Xavier-GAO-42/thuairforce_uav_cuadc/README.md

# CUADC 2025 项目资料

我们需要制作一架固定翼无人机，可以自主起飞，在任务区域内识别数字或图像天井，然后决策向其中一个天井投放物资载荷(一瓶矿泉水)，并自主着落。在无人机起飞后的全流程中不允许对无人机进行任何操作行为。

## 从这里开始

| 想了解什么 | 阅读入口 |
|---|---|
| 飞机要完成什么任务，各设备如何协作 | [系统架构](2025/航电设计/01-系统架构.md) |
| 图像和位姿如何同步，为什么会有误差 | [图像与位姿对齐](2025/航电设计/02-图像与位姿对齐.md) |
| 系统如何部署、启动和排查问题 | [系统启动与操作流程](2025/使用说明/系统启动与操作流程.md) |
| 实现代码与配套文件 | [Jetson 主程序](2025/程序/jetson/README.md) · [树莓派采集系统](2025/程序/rpi5/README.md) |
| 飞机模型、制造文件和打印参数 | [模型与制造](2025/模型/README.md) |
| 最终参数候选及比赛航点 | [飞控参数与比赛航线](2025/飞控与航线/飞控参数与比赛航线.md) |
| 曝光条件和定位观测 | [曝光与定位记录](2025/曝光与定位/曝光与定位记录.md) |
| 当年遇到什么问题，后来考虑如何优化 | [2025 技术复盘](2025反思优化/2025反思与后续优化.md) |

建议先读系统架构的任务、设备分工和执行流程，再按需要进入同步专题、源码或复盘。正文中的未完成工作、推导过程和不同版本判断均保留；后续意见与当年记录分别标识。

署名与许可状态、版本差异和来源校验见 [整理记录](整理记录/README.md)。
