Xavier-GAO-42/thuairforce_uav_cuadc/2025/README.md

# 2025 成果资料

## 1. 理解设计

- [系统架构](航电设计/01-系统架构.md)：任务目标 → 系统总览 → 设备分工 → 执行流程 → 模块设计 → 工程问题。架构图和模型分析图直接放在对应正文中。
- [图像与位姿对齐](航电设计/02-图像与位姿对齐.md)：数据流 → 时间链路 → 匹配机制 → 误差推导 → 原文修正与后续判断。

## 2. 查看实现

- [Jetson 任务程序](程序/jetson/README.md)
- [树莓派图像采集系统](程序/rpi5/README.md)
- [模型与制造](模型/README.md)：整机 CAD、一个可编辑打印工程、打印参数说明及少量独立制造文件。
- [曝光与定位记录](曝光与定位/曝光与定位记录.md)：曝光条件、原始观察和聚类配图。

代码目录及运行所需的配置、航点、模型、测试图片、日志和笔记保持原相对路径。

## 3. 部署与复现

- [系统启动与操作流程](使用说明/系统启动与操作流程.md)
- [飞控参数与比赛航线](飞控与航线/飞控参数与比赛航线.md)：一份最终参数候选及第二轮比赛的六份任务文件。
- [SITL、航点与 DroneKit 开发笔记](程序/jetson/note/note_navigate.md)
- [开发与配置记录](程序/jetson/note/README.md)

## 4. 复盘与版本

- [2025 技术复盘与后续优化](../2025反思优化/2025反思与后续优化.md)
- [历史程序版本差异](../整理记录/历史程序版本差异/README.md)
- [资料来源与整理记录](../整理记录/README.md)
