Xavier-GAO-42/thuairforce_uav_cuadc/2025/模型/README.md

# 2025 模型与制造

## 1. 整机模型

- [整机 STEP](飞机最新版.STEP)：通用交换格式，便于查看和导入 CAD 软件。
- [整机 SolidWorks 零件](飞机最新版.（整体）SLDPRT.SLDPRT)：原生零件格式归档。

这两份为原有整机文件，文件名保持原样。本次未用 CAD 软件打开核验，尚未确认内部细节及比赛最终版身份；整体零件文件不等同于保留全部装配约束和建模历史的装配工程。

## 2. 打印工程与参数

- [v3.99 可编辑整机打印工程](打印工程/v3.99整机-可编辑.3mf)：只保留这一份 3MF，包含整机零件及原打印设置。
- [打印参数与说明](打印参数与说明.md)：材料、温度、层高、填充、支撑和取件说明，并列出不同零件设置的差异及待确认项。

## 3. 独立制造文件

保留少量适合单独加工、修改的文件，其余零件通过整机模型查看。

| 用途 | 文件 |
|---|---|
| 航电甲板，原文件标注板厚 1.7 mm | [底板](制造文件/电设甲板-底板1.7mm.DXF) · [侧板](制造文件/电设甲板-侧板1.7mm.DXF) · [前后板](制造文件/电设甲板-前后板1.7mm.DXF) |
| 起落架 | [加工图 DXF](制造文件/起落架.DXF) |
| 短夹具 | [实心短夹具 SolidWorks 零件](制造文件/实心短夹具.SLDPRT) |

这些文件保留源文件内容。本次未进行 CAD 装配检查、尺寸验收或实际打印验证；未附完整生产图和材料清单。
