Xavier-GAO-42/thuairforce_uav_cuadc/2025/结构设计/README.md

# 2025 结构设计文件

## 目录

- [1. 文件说明](#nav-1)

## 1. 文件说明

- `飞机最新版.STEP`：通用交换格式整机文件。
- `飞机最新版.（整体）SLDPRT.SLDPRT`：SolidWorks 原生零件格式归档。

两个文件均来自历史迁入归档，文件名保持原样。本次未用 CAD 软件打开核验，尚不能确认外部引用、内部细节或比赛最终版身份。它们不等同于完整装配工程、生产图或材料清单。
