Xavier-GAO-42/thuairforce_uav_cuadc/整理记录/历史程序版本差异/README.md

# 历史程序版本差异

## 1. 不同版本

- `cuadc/navigate.py`：独立历史仓库中的另一完整版本。
- `cuadc/.gitignore`：独立历史仓库中的忽略配置。

## 2. 与主程序的关系

这些文件与主归档不同，作为版本对照保留，不是完整可运行副本，也没有覆盖[主程序](../../2025/程序/jetson/README.md)。
