Xavier-GAO-42/thuairforce_uav_cuadc/2025/程序/jetson/README.md

# 2025 Jetson 任务程序

## 1. 先了解系统

[系统架构](../../航电设计/01-系统架构.md)介绍任务流程、硬件连接、服务环境、模块分工、模型与已知问题。

图像与位姿匹配的完整说明和误差推导见 [图像与位姿对齐](../../航电设计/02-图像与位姿对齐.md)。

## 2. 查看程序

主入口为 main.py；config、waypoint、model、picture_test、log 与 note 保持原目录结构。具体文件与模块说明见[系统架构的 Jetson 程序设计](../../航电设计/01-系统架构.md#architecture-4)。

## 3. 部署与调试

- [系统启动与操作流程](../../使用说明/系统启动与操作流程.md)
- [SITL、航点与 DroneKit 笔记](note/note_navigate.md)
- [开发与配置记录](note/README.md)
- [2025 技术复盘](../../../2025反思优化/2025反思与后续优化.md)

源码逻辑未因文档整理而修改。
