Xavier-GAO-42/thuairforce_uav_cuadc/整理记录/发布说明.md

# 发布准备说明

## 1. 材料范围与状态

本包为 2025 成果、原始技术说明及后续复盘。原文中的后续迁移意见、推导、不确定判断、未完成工作和不同版本表述均保留，不把它们写成已完成成果。

署名、许可证、模型与数据来源、图片和 CAD 的权属审阅仍待确认；缺少完整数据集、部分原文提及的权重、部署镜像、完整生产图和材料清单，未确认所有文件的比赛最终版身份。

本次从桌面归档补充一份最终飞控参数候选、第二轮比赛六份航点、曝光与定位技术记录，以及一个可编辑整机 3MF、打印说明和五份独立制造文件。未纳入比赛过程总结、事故分析、飞行调参历史、曝光照片全集或旧参数快照。参数适用机体、航点 Home 不一致、打印局部填充差异等未确认项在对应正文中标明。

## 2. 组织原则

阅读入口围绕“理解任务 → 理解系统 → 查看专题分析 → 查看实现与操作 → 复盘”组织，不按来源文件名建立知识分类。航电设计只保留系统架构、图像与位姿对齐两篇正文和供正文引用的配图。

架构文档中的任务、流程、设备分工、模块、模型、问题和未完成工作重新排序，原句保留。对齐专题中两版独有的触发说明、误差表与判断就地并列，保留结论变化的过程。

程序运行所需的文件名、目录、相对路径与逻辑不变。图片按用途命名，嵌入相应内容。原始测试图片继续在程序目录中保留，不再复制为航电主题。来源、校验和不同程序版本集中到本目录。

## 3. 内容保留边界

技术分析、参数表、公式、代码片段、实验过程和原始异议不通过摘要替代。只合并重复内容，独有内容保留。原始文件仍在工作区原仓库，本次修改前另存了完整备份。

原启动文档两处设备登录口令及其占位提示均不公开。个人用户名路径、内部镜像索取、个人仓库链接和无关写作感叹已清理；复盘中的个人姓名匿名化，技术异议保留。其余技术步骤、推导和判断保留，程序中的历史坐标、内网地址和设备路径未改写。

文本凭据、邮箱、手机号及附件常见凭据模式的检查结果见 `敏感信息检查.json`。二进制模式检查不等于模型或 CAD 的全部内部元数据已人工审阅。

## 4. 验证范围

核对原始材料是否存在对应位置、非文档附件是否与原文件哈希一致、技术正文是否完整覆盖、图片引用与文档链接是否有效。记录与清单见本目录。

没有执行主程序、硬件试验、模型推理或 CAD 内容验收。文档整理及文件校验不代表飞行、复现或发布授权验收完成。
