Xavier-GAO-42/thuairforce_uav_cuadc/2025/模型/打印参数与说明.md

# v3.99 模型打印参数与说明

[可编辑整机 3MF](打印工程/v3.99整机-可编辑.3mf)包含分件摆盘和打印配置。来源为 `v3.99两盘一架（右喷头）.3mf`，内部日期为 2025-09-22，创建软件标记为 BambuStudio 02.02.00.85。本目录只保留这一份打印工程。

## 1. 工程中的全局设置

以下参数直接读取 `Metadata/project_settings.config`，不是重新给出的通用打印配方。

| 项目 | 原工程设置 |
|---|---|
| 打印机 | Bambu Lab H2D，右喷头项目 |
| 喷嘴 | 0.4 mm |
| 耗材 | Bambu ASA-CF |
| 层高 / 首层层高 | 0.24 / 0.2 mm |
| 墙层数 | 1 |
| 全局填充 | 2%，自适应立方体（adaptivecubic） |
| 顶 / 底壳层数 | 3 / 3 |
| 象脚补偿 | 0.1 mm |
| XY 外轮廓 / 孔补偿 | 0 / 0 mm |
| 支撑 | 开启，自动树状支撑 |
| 喷嘴温度 | 首层及其他层均为 275°C |
| 当前底板 | Textured PEI Plate |
| 对应该底板的床温设置 | 90°C |
| 仓温设置 | 60°C |

文件还存有其他底板 100°C 的预设值，不与当前纹理板 90°C 混写。更换设备、耗材或底板后不能直接把上表视为已经验证的适配参数。

## 2. 对象覆盖与局部设置

工程并非所有零件都使用全局 2%：

| 对象 ID | 原对象名称 | 填充设置 |
|---|---|---|
| 30 | 最新版机身-SOLID-6 | 显式覆盖 3% |
| 28 | 最新版机身-SOLID-5 | 显式覆盖 3% |
| 47 | 最新版机身-SOLID-6 | 未覆盖，继承 2% |
| 26 | 最新版机身-SOLID-1 | 未覆盖，继承 2% |

部件树中还存在局部 100% 填充设置。以上覆盖、修改器、支撑和摆放均保留在可编辑工程中，不用一张全局参数表替代。

**待确认：** 同一整机工程的机身对象存在 2%/3% 差异，是有意设计还是遗漏没有明确记录。请在切片软件中按对象核对，不能直接归纳为“全部机身 3%”。

## 3. 冷却、拆支撑与试件

原制造说明记录：

1. 打印结束后让箱温自然冷却到室温，原记录约需 2 h，再取出模型，避免热应力导致破裂。
2. 大树状支撑可以轻轻去除；细小支撑原记录要求由装配人员处理。
3. 床面粘性差时，原记录建议涂胶。
4. 设备状态不确定时，原记录建议先用 1 层墙、2% 填充打印直径 2 cm、高 10 cm 的倾斜圆柱作测试。

原公差说明另写探杆孔径增加 5%–6%，这是对应部件的历史要求，不应无区别套用到所有孔。旧说明中的象脚补偿为 0.15 mm，本工程为 0.1 mm，保留这一差异，不擅自统一。

## 4. 文件与制造边界

整机 STEP、SolidWorks 整体零件和本 3MF 的来源分别保留；本次没有验证三者的几何完全相同，也没有进行新的切片、打印或结构强度试验。

已有说明中的 38 h、900 g 对应另一次具体工程，不作为本文件的统一耗时和用料指标。没有附预切片 G-code，避免把特定机器的执行文件当成通用模型。
