Xavier-GAO-42/thuairforce_uav_cuadc/2025/飞控与航线/飞控参数与比赛航线.md

# 2025 飞控参数与比赛航线

这里只提供一份最终参数候选和第二轮比赛航线，不附历史调参过程或测试航点全集。

## 1. 飞控参数

[1008 自动降落参数表](飞控参数/1008自动降落（最终参数）.param)来自原文件 `1008自动降落（最终参数）.param`，包含 958 个参数项，文件内容保持不变。

“最终参数”为原文件命名，表示当前找到的 10 月 8 日候选，不等于已独立确认是所有比赛机体实际使用的最终配置。该文件没有配套记录固件版本与对应机体；设备 ID、传感器偏置和校准值属于当时的设备状态，不能当作通用设置。

## 2. 第二轮比赛航点

来源为 `德清第二轮比赛航点正确版.zip`。按阅读用途重命名，原始任务内容没有改写。

| 方向 | 侦察航线 | 降落航线 |
|---|---|---|
| 东侧（原 A 组） | [3 轮](比赛航点/东侧方向-侦察3轮.waypoints)、[4 轮](比赛航点/东侧方向-侦察4轮.waypoints) | [降落](比赛航点/东侧方向-降落.waypoints) |
| 西侧（原 B 组） | [3 轮](比赛航点/西侧方向-侦察3轮.waypoints)、[4 轮](比赛航点/西侧方向-侦察4轮.waypoints) | [降落](比赛航点/西侧方向-降落.waypoints) |

3 轮与 4 轮是不同任务选项，不是同一个任务的新旧版本。第二轮包的两份降落任务与普通比赛目录中的版本不同，本目录只采用第二轮包。

航点保留德清原场地坐标。归档文件本身不能证明当时实际上传和执行了完全相同的任务；复用时还需核对方向、坐标、高度基准和任务适用性。

六份文件的序号 0（Home）均在约 `30.4186, 120.0333`，后续非零目标坐标在约 `30.504, 120.106`，位置不一致，疑似保留了其他场地的 Home，原因未确认。文件保持原样，未代改 Home；上传程序如何处理序号 0 也需结合实际实现核对。

## 3. 与程序的关系

这些文件作为比赛配置资料单独提供，没有替换 [Jetson 程序](../程序/jetson/README.md) 中原有的配置和航点。旧代码是否需要 Home 航点、怎样读取和上传任务，见 [SITL 与航点开发笔记](../程序/jetson/note/note_navigate.md)。
