Xavier-GAO-42/thuairforce_uav_cuadc/2025/程序/jetson/note/README.md

# 2025 开发与配置笔记

## 目录

- [SITL、航点与 DroneKit 开发笔记](note_navigate.md)
- [开发待办与联调记录](开发与联调记录.md)
- [参数与配置原始笔记](配置说明.md)
- [自启动服务样例](cuadc.service)

原始无扩展名 note、note_config 文件继续保留，内容未修改。下面两份 Markdown 文档作为阅读入口，保留原句与代码。
