Xavier-GAO-42/thuairforce_uav_cuadc/2025/程序/jetson/waypoint/README.md

# 2025 航点样例

## 目录

- [1. 原始用途说明](#nav-1)

## 1. 原始用途说明

这个文件夹下面的这些航点是用MP直接上传给飞控的
用来测试
