Xavier-GAO-42/thuairforce_uav_cuadc/2025/程序/jetson/note/开发与联调记录.md

# 2025 开发待办与联调记录

## 目录

- [1. 原始开发记录](#nav-1)

## 1. 原始开发记录

develop notes

todo
(todo)设置开机自启动，目前这个python程序需要让它的工作目录在这个CUADC文件夹。
(todo)EKF插值的调参与测试
(done)locate的测试需要注意。换算与纬度位置好像有关系。另外注意确认一下它的单位是否正确
(todo)navigate的航点规划和打击程序，等待测试
(todo)在树莓派传输图片之前，一定要确保树莓派的时间已经和卫星时间校准了(还没写)
(todo)在树莓派上做一个装订程序，从I2C连接流明计，接收流明数值，计算快门时间

位姿队列和图像队列的时间戳顺序一定要连续上升(done)
navigate中可以用EKF进行插值(done)
做一个json配置文件，根据不同飞场进行配置航点、默认打击目标与降落目标、以及模型路径和任务类型与靶标颜色等各类全局变量(done)
做main.py与capture_nfs.py的自启动和自检模块。(done)
首先树莓派确认时间已经校准，
  nfs：可以在nfs目录下发送一个空的文件ready，(并且发送时间戳信息?)，mqtt_receiver收到后。
  mqtt：通过主题TOPIC="filename"发送信号ready
在jetson这边确认时间戳没问题后，jetson这边发送一个mqtt信息"start capture"，树莓派再开始拍摄
jetson最后通过mqtt主题COMMAND_TOPIC发送mqtt消息"stop capture"，树莓派停止拍摄（每10秒检测一次?）
这个还需要再设计一下

note:
mqtt插上网口才能用，要不然没有BROKER以太网ip，connect不了(note)
飞机起飞前要放在地上直到d接收到gps信号并设置好home海拔
