Xavier-GAO-42/thuairforce_uav_cuadc/2025/程序/jetson/note/配置说明.md

# 2025 参数与配置笔记

## 目录

- [1. 原始参数记录](#nav-1)

## 1. 原始参数记录

```text
#我在这里梳理一下到底要多少配置信息
mission = 0 # 0识别图案 1识别数字
mission_color = 'red' # 任务颜色 need to be edited
detect:
    # 聚类参数配置
    MIN_SAMPLES = 5         # 形成簇所需的最小样本数
    EPS_METERS = 10          # 聚类半径(米)
    MIN_CLUSTER_SIZE = 6    # 有效簇的最小点数

    # 时间戳对齐配置参数
    ALIGN_THRESHOLD = 10  # 时间戳对齐阈值(10ms) 其实不需要

locate:
    # 摄像头拍摄参数
    fx = 1458.40414996006
    fy = 1454.16583600491
    centerx = 940.803400908533
    centery = 466.179229582737

mqtt_receiver:
    # MQTT配置
    BROKER_IP = "192.168.144.25"  # 使用本机自身IP 本机同时作为mqtt接收端与broker need to be edited
    PORT = 1883
    TOPIC = "filename"

navigate:
    # 默认打击位置
    attack_lat_default
    attack_lon_default
    # 插值输出pose流的频率，要和树莓派照片流保持一致
    pose_fps
    # 航线规划配置

rtsp:
    rtsp_url = "rtsp://192.168.144.25:8554/durant"
    # 照片像素大小，要和树莓派保持一致
    width=1920
    height=1080
    mediamtx_path="/home/thuair/mediamtx/mediamtx"
    mediamtx_conf_path="/home/thuair/mediamtx/mediamtx.yml"

yolo:
    modelpath_extract_tianjing_blue = './812_blue_n.engine'
    modelpath_extract_tianjing_red = './812_red_n.engine'
    modelpath_extract_white = './812_white.engine'
    modelpath_number = './812_num_n.engine'
    modelpath_graph = './812_graph.engine'

{
  "mission": 1, # 任务类型：0识别图案 1识别数字
  "mission_color": "blue", # 靶标颜色 red blue
  "navigate": {
    "connection_string": "/dev/ttyACM0,57600",
    "attack_lat_default": 39.58555104, # 默认打击地点
    "attack_lon_default": 116.19916596,# 默认打击地点
    "centerpoint_lat":39.58555104, # 打击区域中心点
    "centerpoint_lon":116.19916596,# 打击区域中心点
    "region_DEG":270.0, # 打击区域方向（北东角）飞机会从这个方向的反方向入场
    "region_EDGE":60,   # 打击的正方形区域的边长
    "pose_fps": 10, # EKF需要输出的姿态信息频率

    "BATTERY_CELL_COUNT":6, # 电池是几S的
    "ACC_R":10, # 与航点距离多远视作通过了航点
    "LAUNCH_ALTITUDE":10, # 起飞达到的高度
    "LAUNCH_SPEED":25, # 起飞地速（用于set ground speed命令，但可能没用）
    "DETECT_LOOP":5,   # 侦查航线的重复次数
    "DETECT_ALTITUDE":30, # 侦查航线的海拔高度
    "DETECT_SPEED":15, # 侦查地速（用于set ground speed命令，但可能没用）
    "DETECT_R":15, # 侦查过程进行转弯掉头的盘旋半径

    "ATTACK_LOOP":4, # 打击航线的重复次数
    "ATTACK_ALTITUDE":10, # 打击地速（用于set ground speed命令，但可能没用）
    "ATTACK_SPEED":15, # 打击速度（用于set ground speed命令，但可能没用）
    "ATTACK_R":20,# 打击过程进行转弯掉头的盘旋半径
    "DROP_WP_DIS":5,# 投蛋距离阈值。计算出的打击点距离目标的距离小于这个数值就投蛋。
    
    "LAND_WAYPOINT_FILE_PATH": "./config/land.waypoints" # 返航航线
  },
  "drop": { # 用于trajectory.py中的弹道计算
    "correction_t": 0 # 投蛋距离计算的偏移量。单位是时间s。需要实验。如果投弹延时比较大（蛋飞过了靶标），可以增加这个数值 单位为秒
  },
  "detect": {
    "MIN_SAMPLES": 5,
    "EPS_METERS": 10,
    "MIN_CLUSTER_SIZE": 6,
    "ALIGN_THRESHOLD": 10
  },
  "locate": { # 标定相机得到的结果，用于locate.py
    "fx": 1503.7,
    "fy": 1475.0,
    "centerx": 960,
    "centery": 540
  },
  "mqtt_receiver": { # 用于mqtt服务和rpi5通信
    "BROKER_IP": "192.168.144.25",
    "PORT": 1883,
    "TOPIC": "filename",
    "COMMAND_TOPIC": "command",
    "do_raspi_check": 1
  },
  "rtsp": { # 用于rtsp推流
    "rtsp_url": "rtsp://192.168.144.25:8554/durant",
    "width": 1920,
    "height": 1080,
    "mediamtx_path": "/home/thuair/mediamtx/mediamtx",
    "mediamtx_conf_path": "/home/thuair/mediamtx/mediamtx.yml"
  },
  "yolo": { # yolo模型路径
    "modelpath_extract_tianjing_blue": "./model/812_blue_n.engine", # 用于提取蓝色靶标的模型
    "modelpath_extract_tianjing_red": "./model/812_red_n.engine", # 用于提取红色靶标的模型
    "modelpath_extract_white": "./model/812_white.engine", # 用于提取白色正方形靶标的模型 目前的方案不用了
    "modelpath_number": "./model/812_num_n.engine",
    "modelpath_graph": "./model/812_graph.engine"
  }
}
```
