Xavier-GAO-42/thuairforce_uav_cuadc/2025/模型/制造文件/实心短夹具.SLDPRT

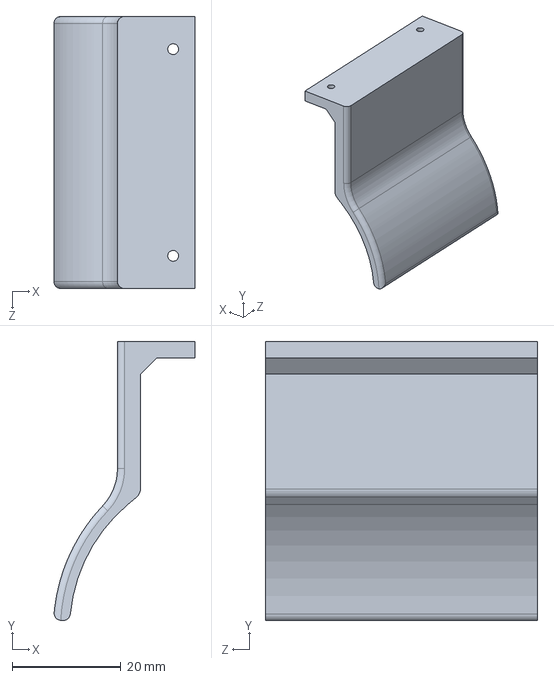
[picture p4: CAD file, 2026-10-23]
2025/模型/制造文件/实心短夹具.SLDPRT
25.9 x 51.3 x 50.0 mm
