Xavier-GAO-42/thuairforce_uav_cuadc/2025/模型/制造文件/电设甲板-侧板1.7mm.DXF

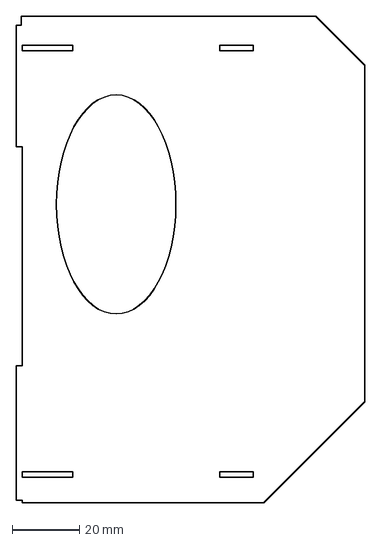
[picture p5: CAD file, 2026-10-23]
2025/模型/制造文件/电设甲板-侧板1.7mm.DXF
103.5 x 144.5 mm
