Xavier-GAO-42/thuairforce_uav_cuadc/2025/结构设计/飞机最新版.（整体）SLDPRT.SLDPRT

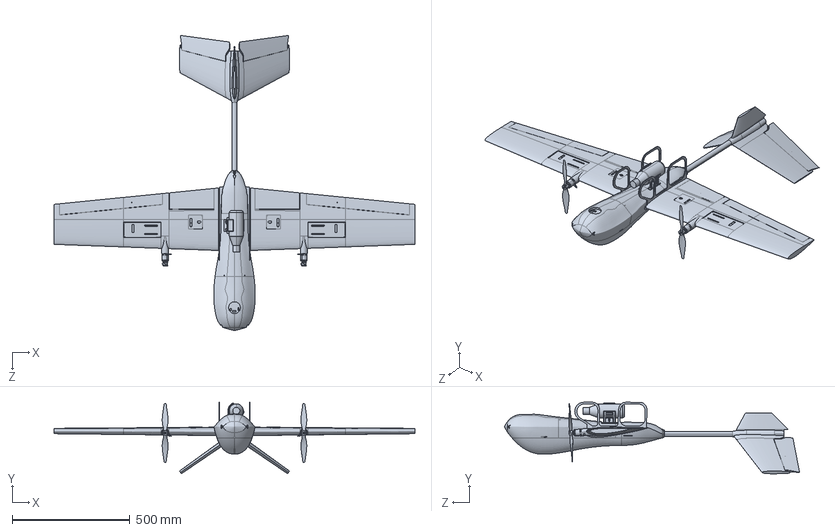
[picture p6: CAD file, 2026-10-23]
2025/结构设计/飞机最新版.（整体）SLDPRT.SLDPRT
1534.9 x 304.5 x 1255.2 mm
