Xavier-GAO-42/thuairforce_uav_cuadc/2025/模型/制造文件/电设甲板-底板1.7mm.DXF

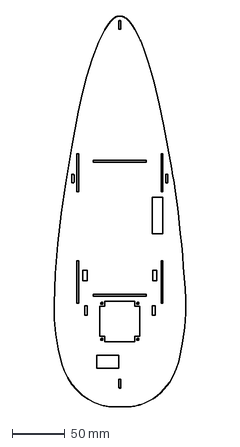
[picture p7: CAD file, 2026-10-23]
2025/模型/制造文件/电设甲板-底板1.7mm.DXF
125.2 x 369.2 mm
