Xavier-GAO-42/thuairforce_uav_cuadc/2025/模型/制造文件/起落架.DXF

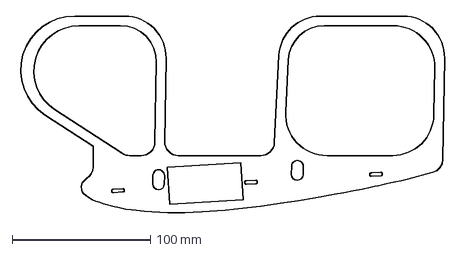
[picture p8: CAD file, 2026-10-23]
2025/模型/制造文件/起落架.DXF
310.4 x 142.6 mm
