Xavier-GAO-42/thuairforce_uav_cuadc/2025/模型/制造文件/电设甲板-前后板1.7mm.DXF

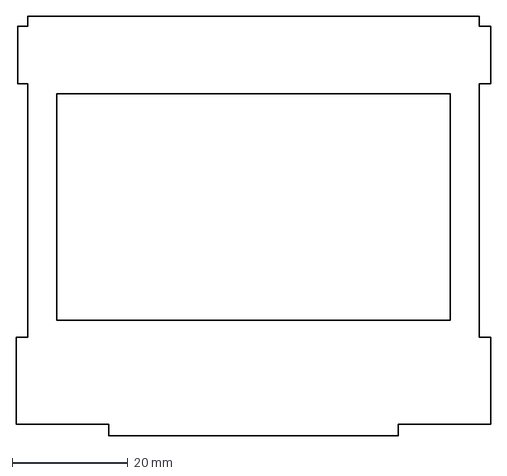
[picture p9: CAD file, 2026-10-23]
2025/模型/制造文件/电设甲板-前后板1.7mm.DXF
82.0 x 72.4 mm
