Xavier-GAO-42/thuairforce_uav_cuadc/(list of files, cad)

Other CAD files:
2025/模型/打印工程/v3.99整机-可编辑.3mf
2025/结构设计/飞机最新版.STEP
