Xavier-GAO-42/thuairforce_uav_cuadc/2025/程序/jetson/log/navigate_test/navigate_analyzer.png

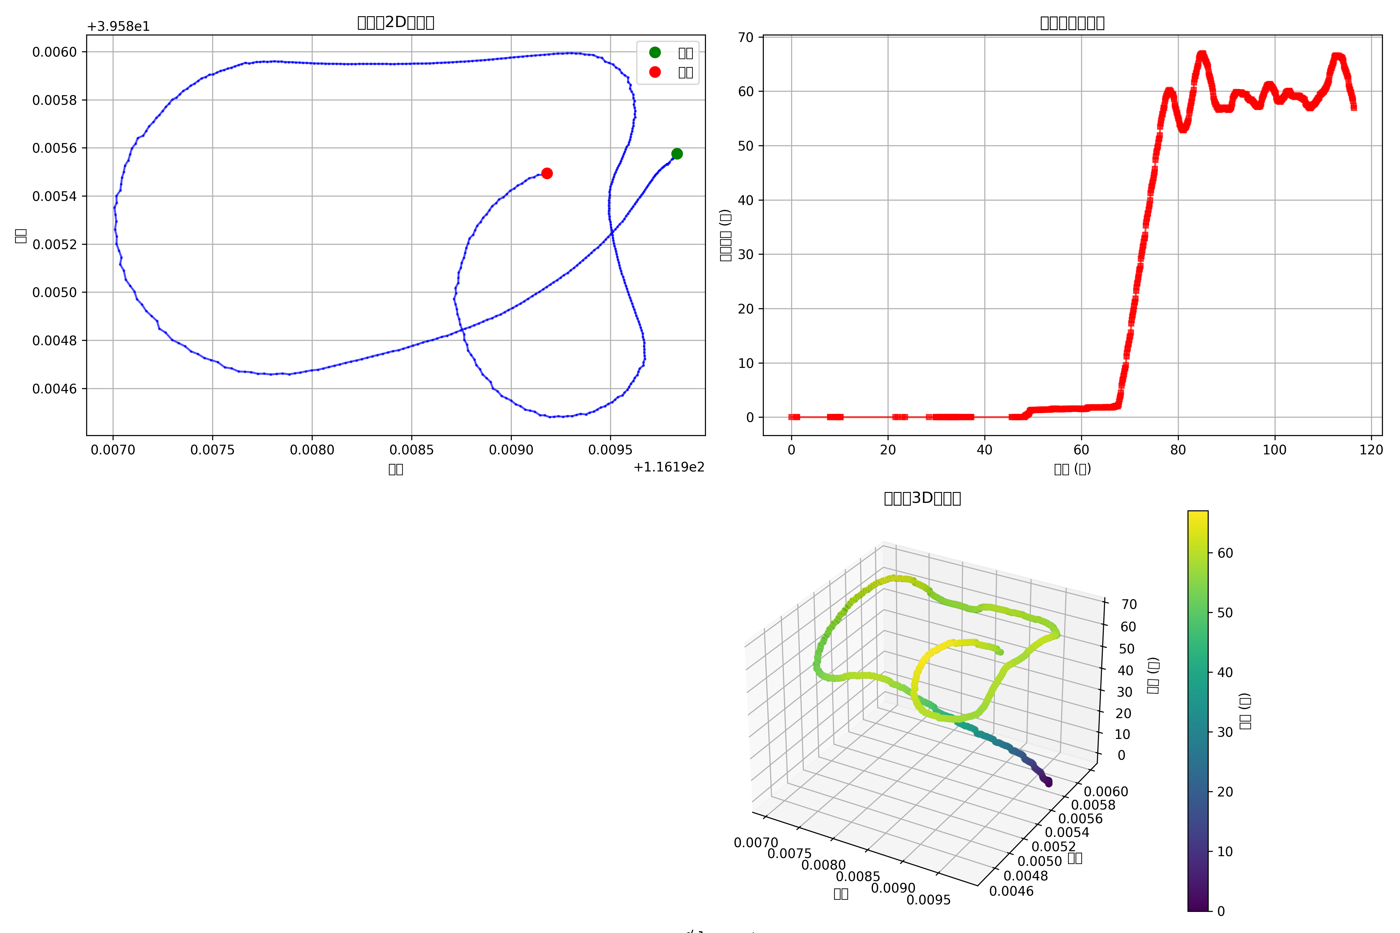
2025/程序/jetson/log/navigate_test/navigate_analyzer.png
