Xavier-GAO-42/thuairforce_uav_cuadc/2025/程序/jetson/picture_test/image-1.png

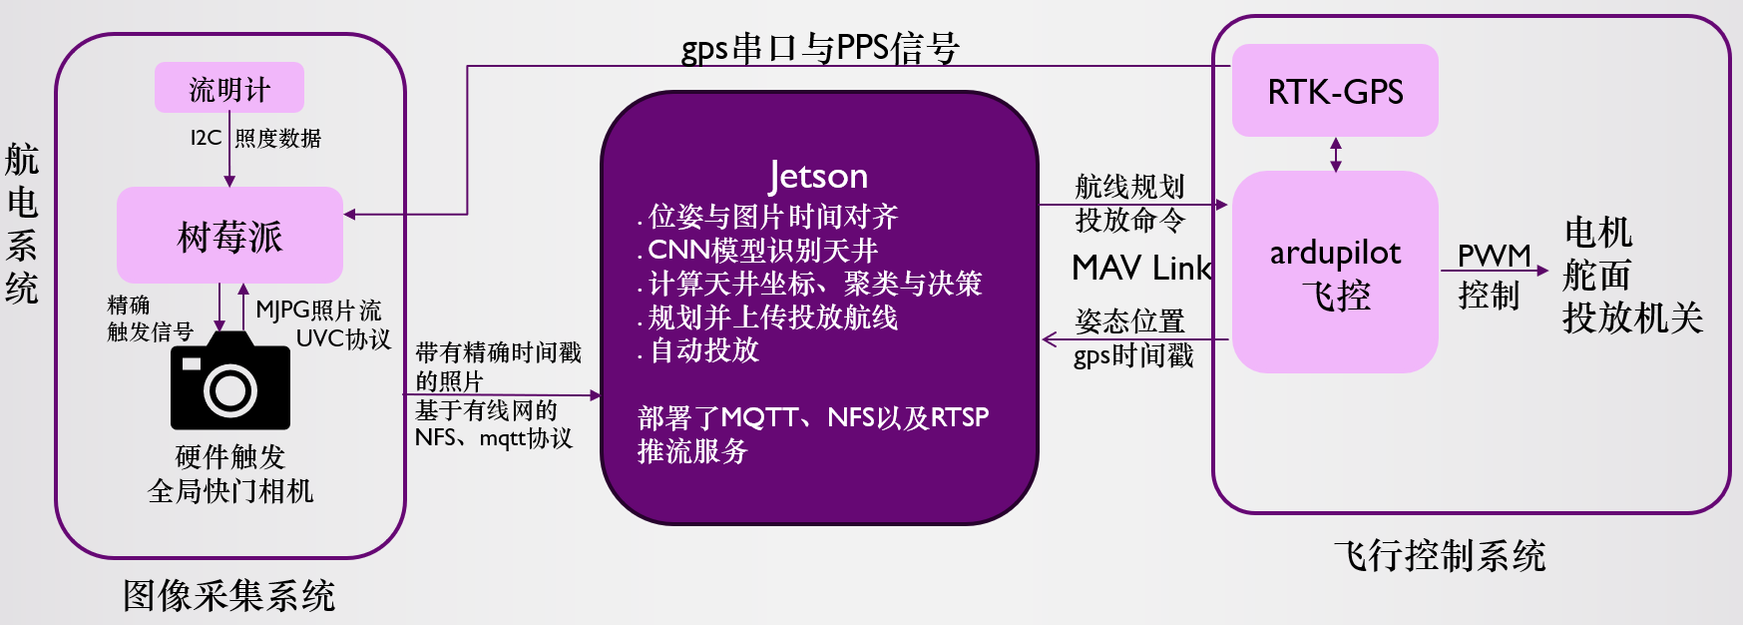
2025/程序/jetson/picture_test/image-1.png
