Xavier-GAO-42/thuairforce_uav_cuadc/2025/程序/jetson/picture_test/test_graph1.jpg

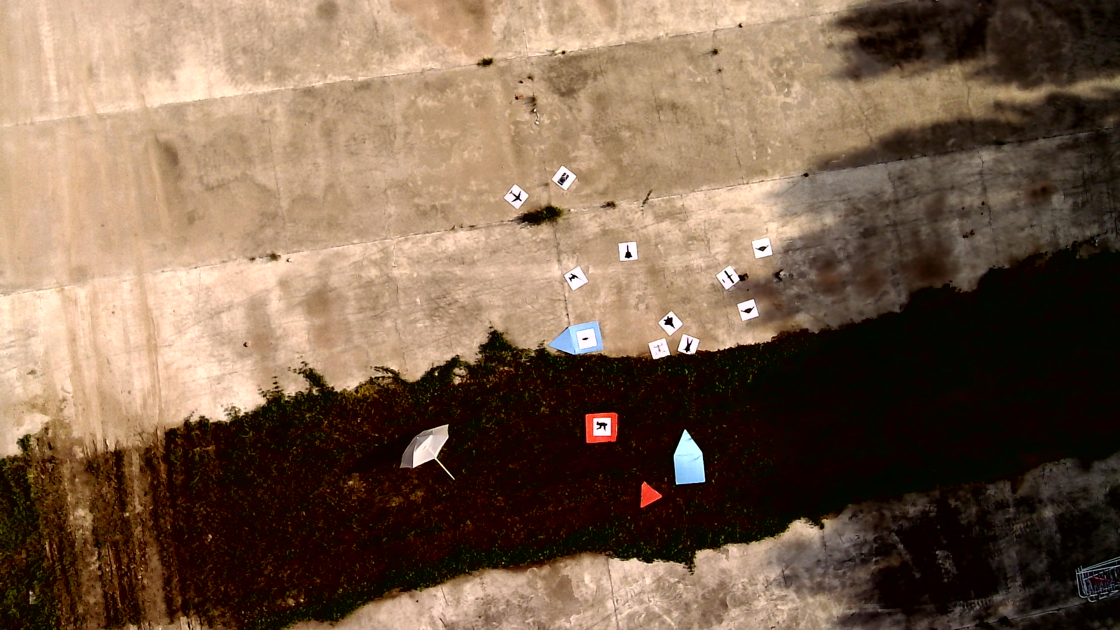
2025/程序/jetson/picture_test/test_graph1.jpg
