Xavier-GAO-42/thuairforce_uav_cuadc/2025/飞控与航线/飞控参数/1008自动降落（最终参数）.param

BATT_AMP_OFFSET,0
BATT_AMP_PERVLT,24
BATT_ARM_MAH,0
BATT_ARM_VOLT,0
BATT_CAPACITY,3300
BATT_CRT_MAH,0
BATT_CRT_VOLT,22
BATT_CURR_PIN,1
BATT_FS_CRT_ACT,0
BATT_FS_LOW_ACT,0
BATT_FS_VOLTSRC,0
BATT_LOW_MAH,0
BATT_LOW_TIMER,10
BATT_LOW_VOLT,22.5
BATT_MONITOR,4
BATT_OPTIONS,0
BATT_SERIAL_NUM,-1
BATT_VLT_OFFSET,0.015
BATT_VOLT_MULT,18
BATT_VOLT_PIN,0
BATT_WATT_MAX,0
BATT2_MONITOR,0
BATT3_MONITOR,0
BATT4_MONITOR,0
BATT5_MONITOR,0
BATT6_MONITOR,0
BATT7_MONITOR,0
BATT8_MONITOR,0
BATT9_MONITOR,0
FLTMODE_CH,8
FLTMODE_GCSBLOCK,0
FLTMODE1,2
FLTMODE2,0
FLTMODE3,5
FLTMODE4,10
FLTMODE5,26
FLTMODE6,13
INS_GYRO_FILTER,20
INS_HNTCH_ENABLE,0
SERIAL0_BAUD,921
SERIAL0_PROTOCOL,2
SERIAL1_BAUD,57
SERIAL1_OPTIONS,0
SERIAL1_PROTOCOL,2
SERIAL2_BAUD,57
SERIAL2_OPTIONS,0
SERIAL2_PROTOCOL,2
SERIAL3_BAUD,38
SERIAL3_OPTIONS,0
SERIAL3_PROTOCOL,5
SERIAL4_BAUD,38
SERIAL4_OPTIONS,0
SERIAL4_PROTOCOL,5
SERIAL5_BAUD,57
SERIAL5_OPTIONS,0
SERIAL5_PROTOCOL,-1
SERIAL6_BAUD,57
SERIAL6_OPTIONS,0
SERIAL6_PROTOCOL,-1
SERIAL7_BAUD,57
SERIAL7_OPTIONS,0
SERIAL7_PROTOCOL,-1
SERVO1_FUNCTION,4
SERVO1_MAX,1900
SERVO1_MIN,1100
SERVO1_REVERSED,0
SERVO1_TRIM,1500
SERVO2_FUNCTION,4
SERVO2_MAX,1900
SERVO2_MIN,1100
SERVO2_REVERSED,0
SERVO2_TRIM,1500
SERVO3_FUNCTION,70
SERVO3_MAX,2000
SERVO3_MIN,1000
SERVO3_REVERSED,0
SERVO3_TRIM,1000
SERVO4_FUNCTION,70
SERVO4_MAX,2000
SERVO4_MIN,1000
SERVO4_REVERSED,0
SERVO4_TRIM,1000
SERVO5_FUNCTION,80
SERVO5_MAX,2000
SERVO5_MIN,1000
SERVO5_REVERSED,1
SERVO5_TRIM,1500
SERVO6_FUNCTION,79
SERVO6_MAX,2000
SERVO6_MIN,1000
SERVO6_REVERSED,0
SERVO6_TRIM,1500
SERVO7_FUNCTION,3
SERVO7_MAX,1900
SERVO7_MIN,1500
SERVO7_REVERSED,0
SERVO7_TRIM,1500
SERVO8_FUNCTION,3
SERVO8_MAX,1500
SERVO8_MIN,1100
SERVO8_REVERSED,1
SERVO8_TRIM,1300
SERVO9_FUNCTION,62
SERVO9_MAX,2000
SERVO9_MIN,1000
SERVO9_REVERSED,0
SERVO9_TRIM,1500
